civanchevik/463-Term-Project/Reports/Complete_Simulation_Report_Presentation (1).pptx

EE-463 Static Power Conversion – 1
Term Project Feedback Session
Civan Serhat Çevik
Yusuf Toprak Yıldıran
Batuhan Elmas

## Outline

- 1- Topology Selection
- 2- Simulation Results
- 3- Component Selection

## 1- Topology Selection

- Three Phase Full Bridge Diode Rectifier
  - High Average Output Voltage
  - Relatively Lower Ripple Voltage
  - Elimination of Third Multiple of Harmonics
- Buck Converter
  - Efficiency
  - Simple to Implement
  - Low Side Switching

## 2- Simulations

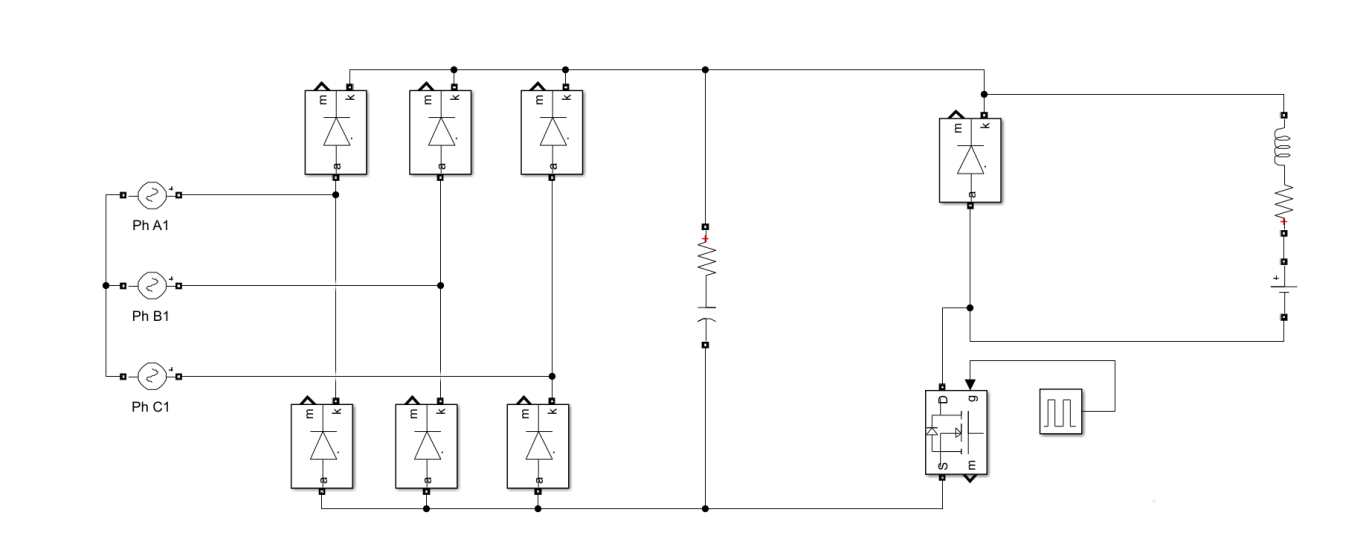
[picture p23: figure]

## 2- Simulations

- Ideal diodes and switch , D=0.8
- Rated motor conditions
- Modelling DC motor parameters:

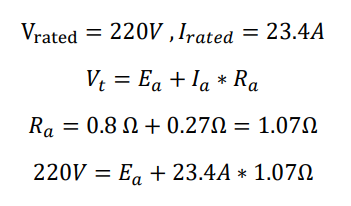
[picture p24: figure]

Armature + Interpole

Armature + Interpole

Back EMF

## 2- Simulations

- Buck Converter Switching Frequency
- Expected Output Current: 2.5 kW=180V ∗14 A
- Desired Current Ripple: 3% 14 ∗0.03=0.4A

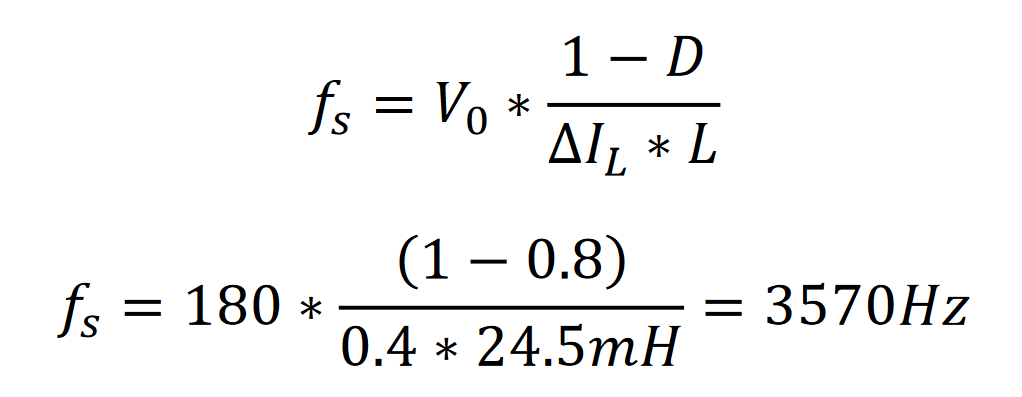
[picture p25: figure]

## 2- Simulations

- a) Rectifier Diodes Voltage - Vmax=300V

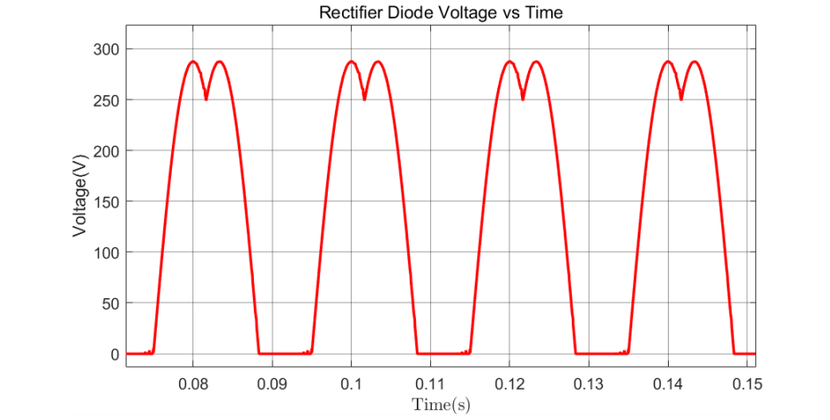
[picture p26: figure]

## 2- Simulations

a) Rectifier Diodes Current - Imax=26A

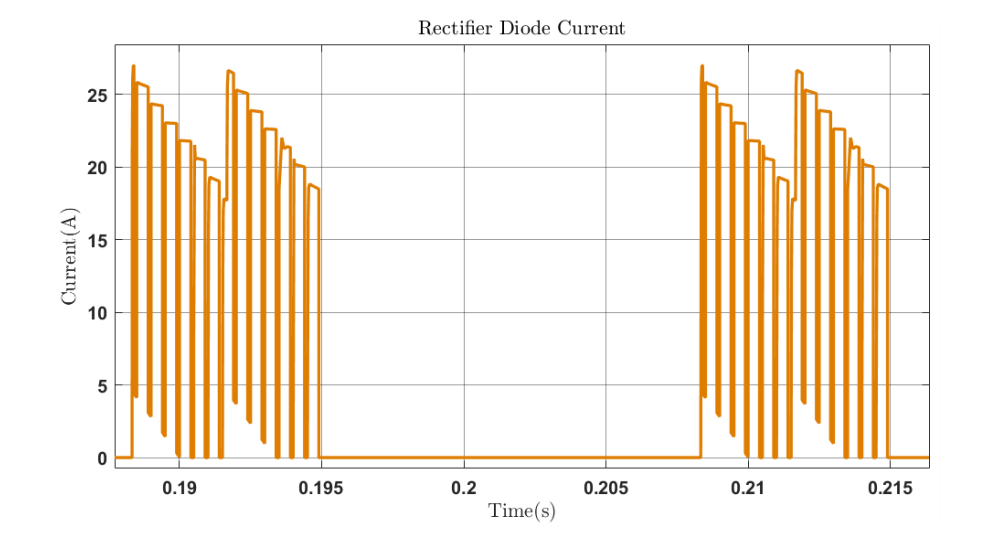
[picture p27: figure]

## 2- Simulations

b) Buck Converter Switch Voltage- Vmax=300V

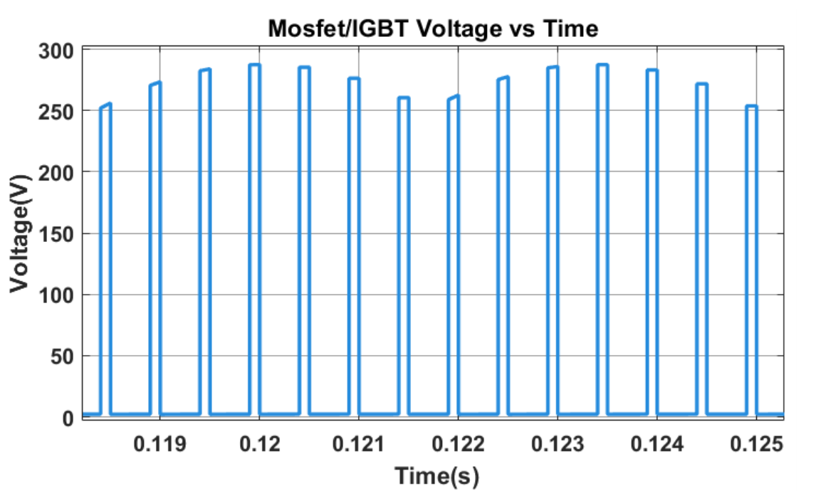
[picture p28: figure]

## 2- Simulations

b) Buck Converter Switch Current- Imax=25A

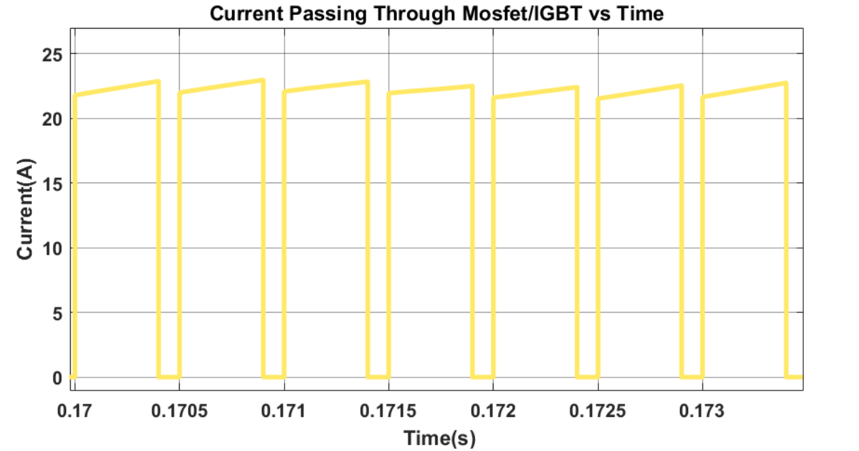
[picture p29: figure]

## 2- Simulations

c) Buck Converter Freewheeling Diode Voltage - Vmax=300V

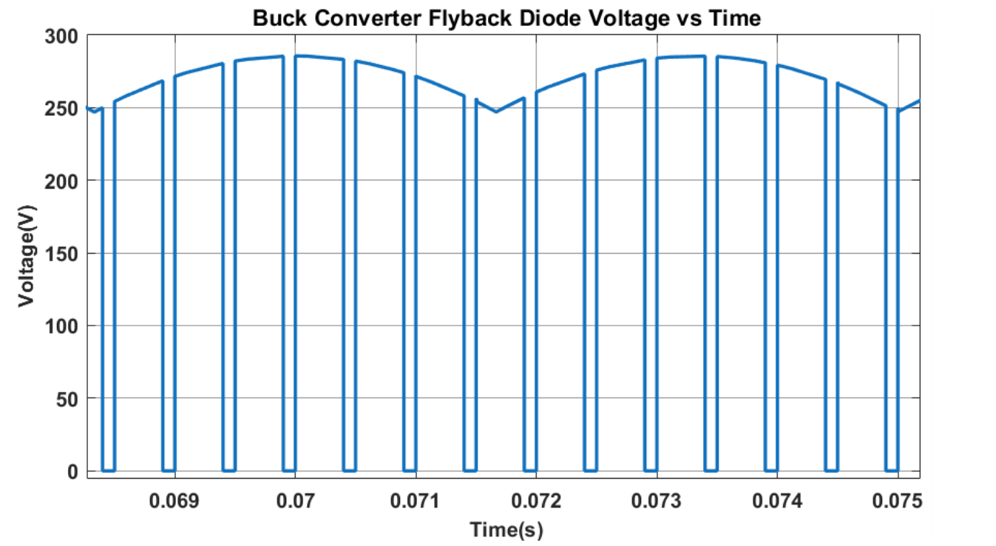
[picture p30: figure]

## 2- Simulations

c) Buck Converter Freewheeling Diode Current- Imax=23A

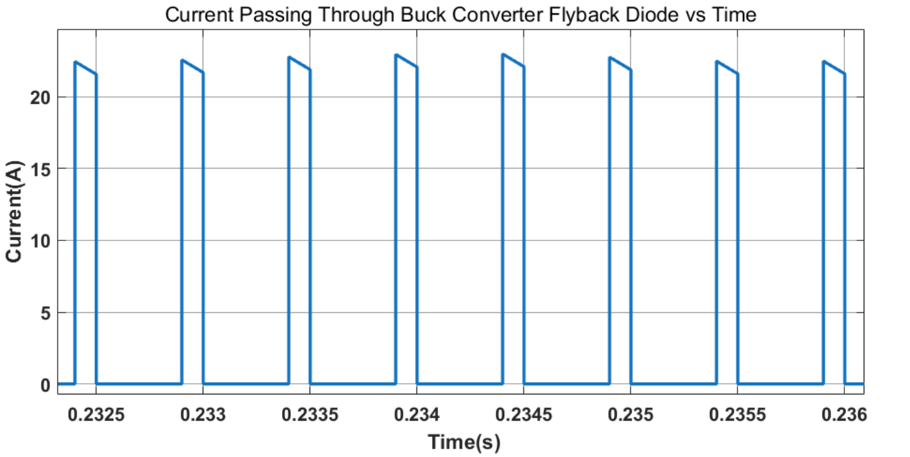
[picture p31: figure]

## 3- Component Selection

- a) Rectifier Diodes - GUO4012NO1
- Single module rectifier
- Simple to implement-THT
- Cooling is more important!

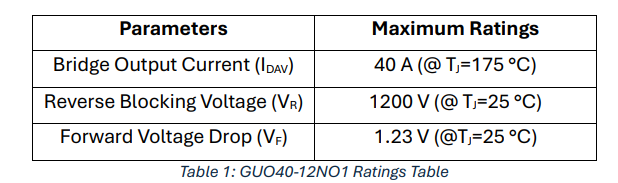
[picture p32: figure]
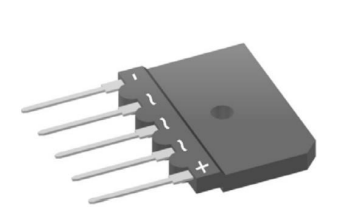
[picture p33: figure]
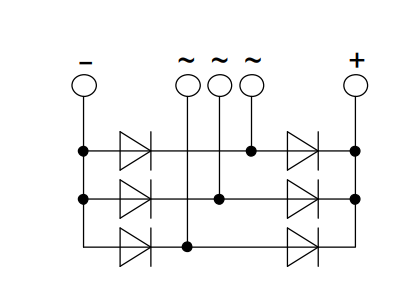
[picture p34: figure]

## 3- Component Selection

- b) Rectifier DC-Link Capacitor
- Electrolytic Capacitor
- 400 V – 47 µF
- Parallel Connection, Lower ESR

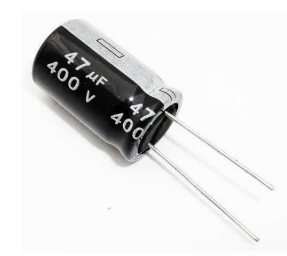
[picture p35: figure]

## 3- Component Selection

- c) Buck Converter Switch - IXGH30N60C2
- High voltage ratings
- Switching frequency is not very high (3kHz)
- IGBT is suitable

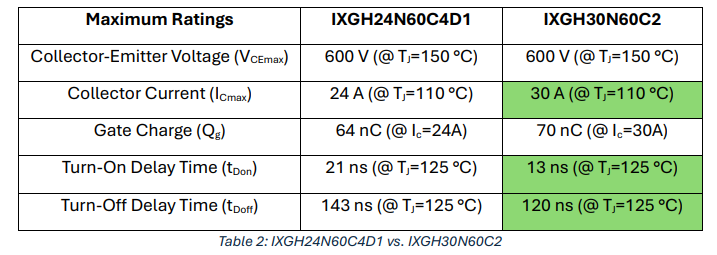
[picture p36: figure]
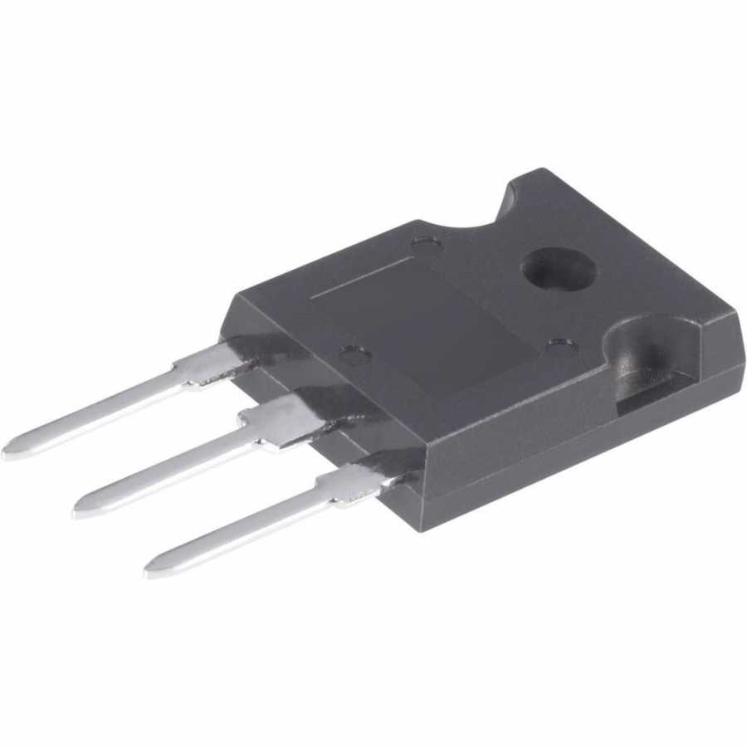
[picture p37: figure]
IXGH30N60C2 N Kanal IGBT Transistör 70A 600V TO-247

## 3- Component Selection

- d) Buck Converter Freewheeling Diode - DSEI3006A
- Fast Recovery, suitable for our frequency range
- Can withstand the values up to 37A and 600V

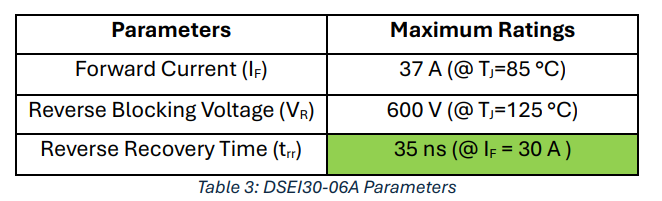
[picture p38: figure]

## 3- Component Selection

- e) Gate Driver
- Timer IC: TL494, Astable operation,
- Internal 5V Reference Voltage
- Optocoupler for isolation: TLP250

## Slide 18
