civanchevik/463-Term-Project/Component Selection/BOM.xlsx

Tipi | Komponent | Adet | Labda var mı? | Fiyat | Link | Voltage Rating | Current Rating | Column1
Buck Diode | DSEI30-06A |  | Yok |  | https://www.ozdisan.com/guc-yari-iletkenleri/diyot-modul-diyot-dogrultucular/hizli-diyotlar/DSEI30-06A | 600V | 37A
Rectifier | SKBPC5004 Three Phase Bridge Rectifier | 1 | Yok |  | https://www.motorobit.com/skbpc5016-50a-1600v-trifaze-kopru-diyot-3-faz | 1600V | 50A
Rectifier | 36MT120 36A 1200V Trifaze Köprü Diyot 3 Faz - Altın Pin | 1 | Yok |  | https://www.motorobit.com/36mt120-36a-1200v-trifaze-kopru-diyot-3-faz-altin-pin | 1200 V | 36A
Rectifier | POWERSEM PSD 68/16 RECTIFIER BRIDGES KÖP |  | Yok |  | https://www.hatfon.com/urun/powersem-psd-68-16-rectifier-bridges-kopru-trifaze-68a-1600v | 1600V | 68A
Rectifier | GUO40-12NO1 |  | Yok |  | https://ozdisan.com/guc-yari-iletkenleri/diyot-modul-diyot-dogrultucular/kopru-diyotlar/GUO40-12NO1 | 1200V | 40A | Through Hole Rects: https://ozdisan.com/p/473?ids=10212;780950,9693;355004&groupids=10212,9693&propids=780950,355004&sayfaAdedi=20
Switch | IXGH24N60C4D1 N Channel IGBT | 1 | Var |  | https://www.direnc.net/ixgh24n60c4d1-rohs-24a600v-to247ad-igbtdiode | 600 V | 30A
Capacitor | 47uF 400V |  | Yok |  | https://www.direnc.net/47uf400v-en | 400 V
Switch | IXGH30N60C2 |  | Yok |  | https://ozdisan.com/guc-yari-iletkenleri/igbtler/discrete-igbtler/IXGH30N60C2/336872 | 600V | 30A
