civanchevik/463-Term-Project/(list of files, drawings)

Other design files:
PCB/PCB_Project/PCB1.PcbDoc
PCB/PCB_Project/PCB_Project.PrjPcb
PCB/PCB_Project/Sheet1.SchDoc
