civanchevik/463-Term-Project/(commit log)

2024-11-08 simulation and component list files
    [Components.xlsx]
2024-11-17 Update on 3 phase rectifier selection
    [BOM.xlsx]
2024-11-18 Final Complete Simulation Report Uploaded
    [BOM.xlsx]
2025-01-20 Final Update All
    [PCB1.PcbDoc, PCB_Project.PrjPcb, Sheet1.SchDoc]
